DDTMotor/Debug_Card/doc/schematic.pdf

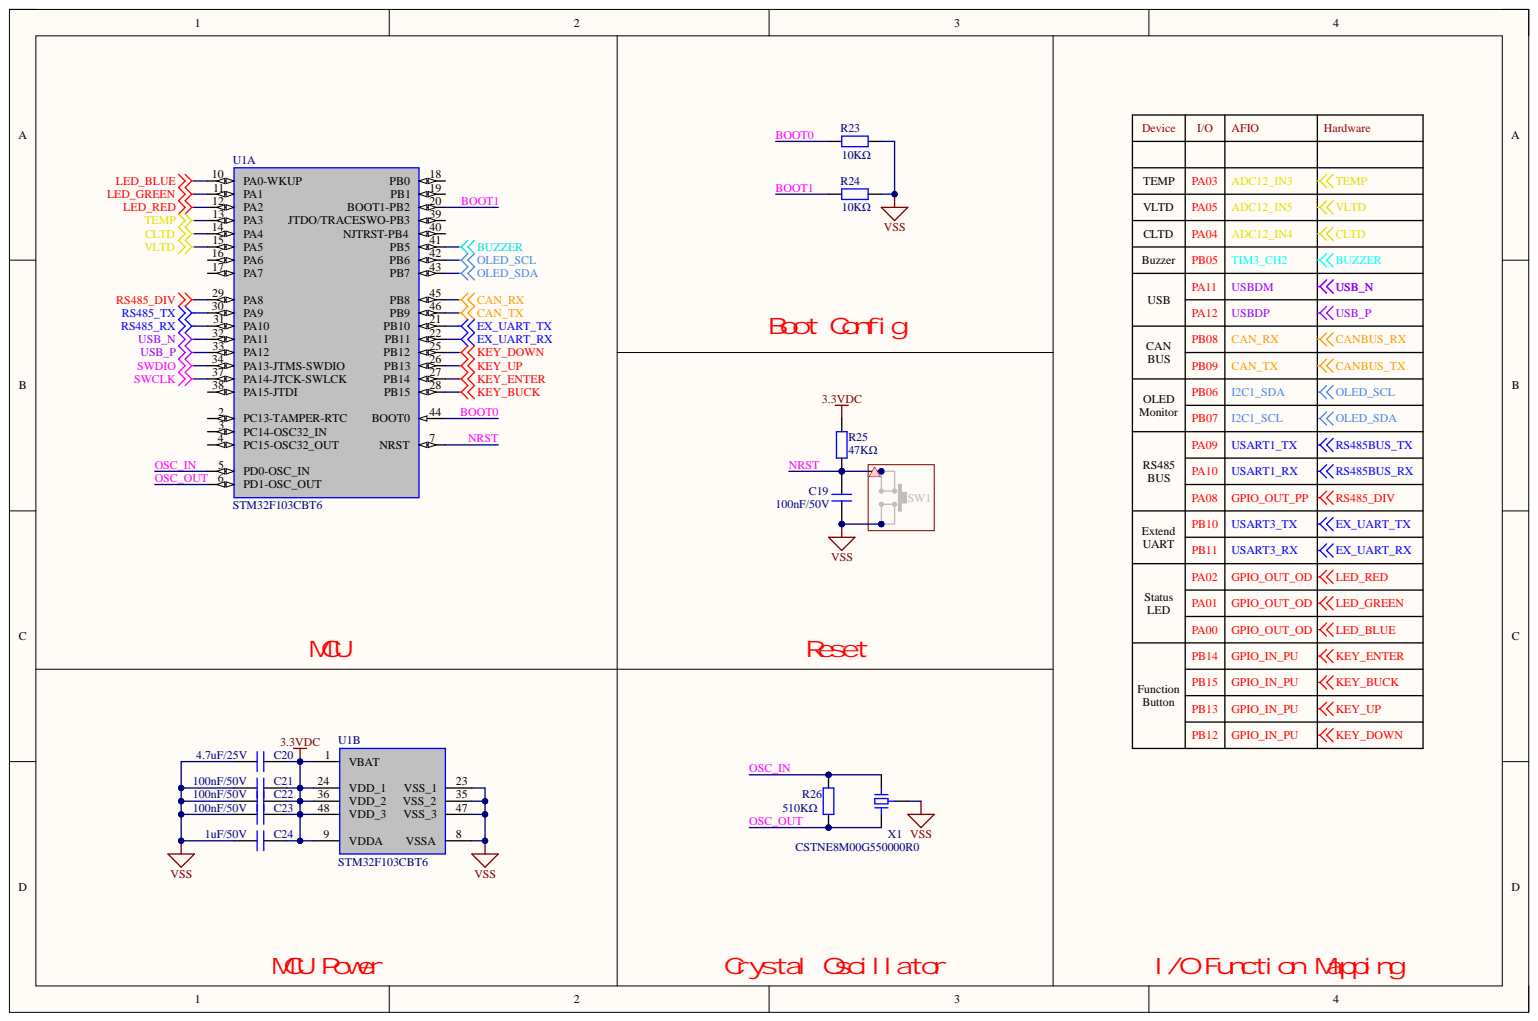
[picture p22: page 1]

CLTD | PA04 | ADC12_IN4 | CLTD

Buzzer | PB05 | TIM3_CH2 | BUZZER

USB | PA12 | USBDM USBDP PA11 | USB_N

USB_P

CAN BUS | PB08 | CAN_RX | CANBUS_RX

OLED | PB06 | I2C1_SDA | OLED_SCL

PB07 | I2C1_SCL | OLED_SDA

RS485 BUS | PA09 | USART1_TX PA10 | RS485BUS_TX

USART1_RX | RS485BUS_RX

PA08 | GPIO_OUT_PP | RS485_DIV

Extend UAR T | PB10 | USART3_TX | EX_UART_TX

PB1 1 | USART3_RX | EX_UART_RX

PA02 | GPIO_OUT_OD | LED_RED PA01 PA00 LED_GREEN

Status LED
Function Button | PB14 | GPIO_IN_PU GPIO_OUT_OD GPIO_OUT_OD GPIO_IN_PU GPIO_IN_PU GPIO_IN_PU | KEY_ENTER

LED_BLUE

PB15 | | KEY_BUCK

PB13 | | KEY_UP

PB12 | | KEY_DOWN

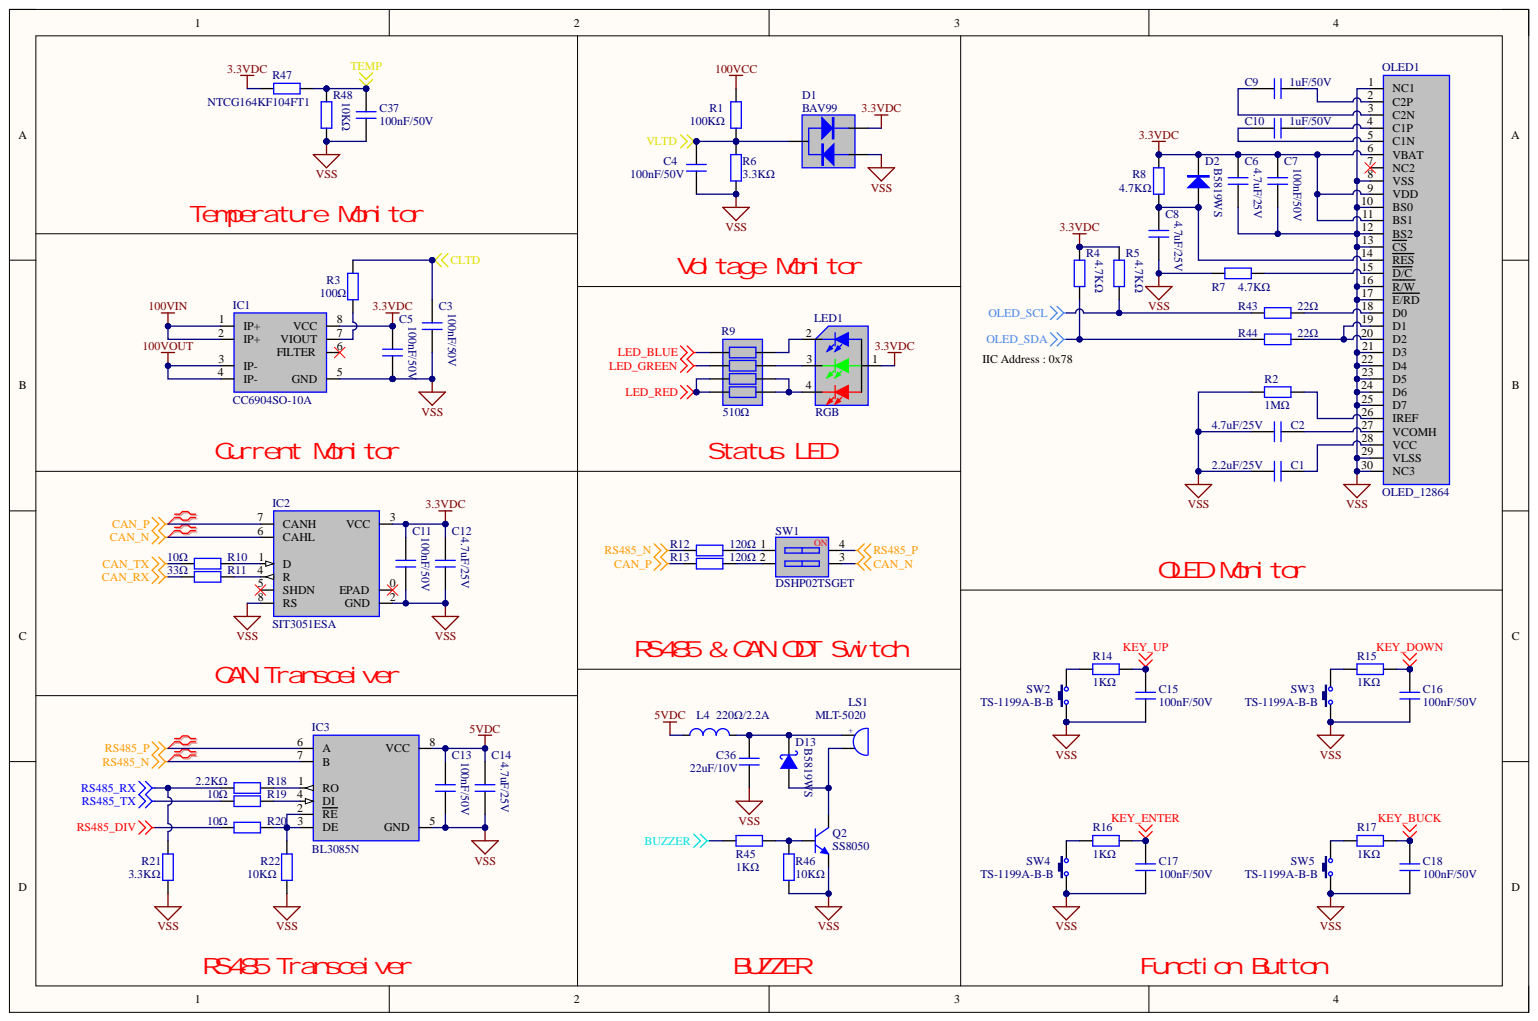
[picture p23: page 2]

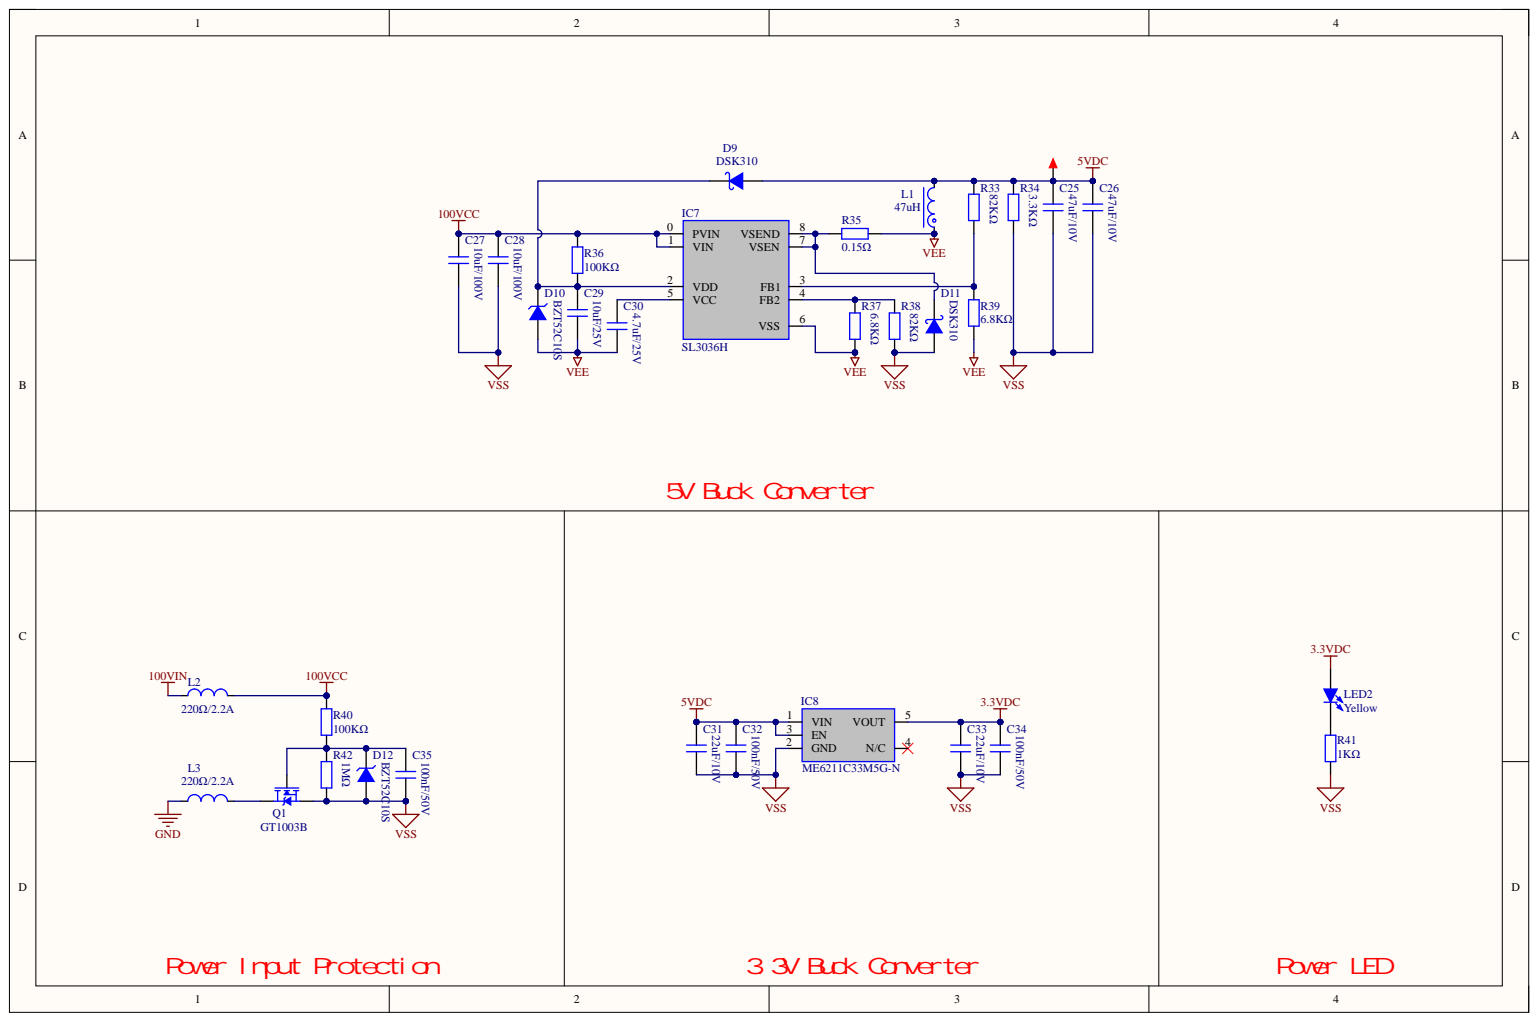
[picture p24: page 3]

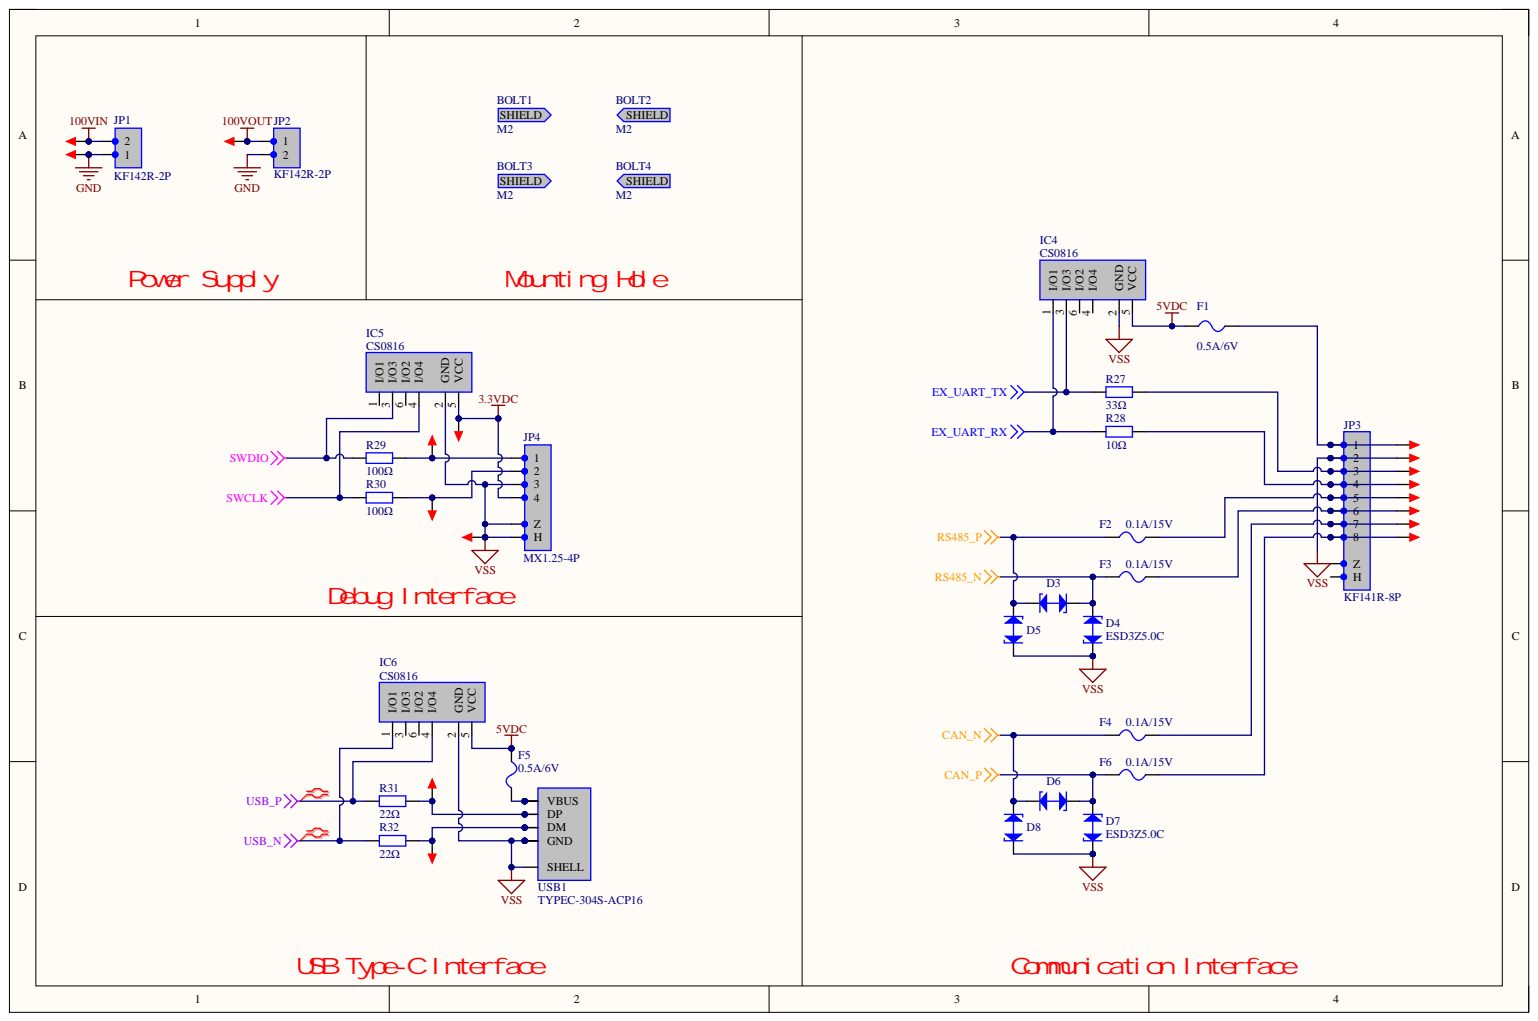
[picture p25: page 4]

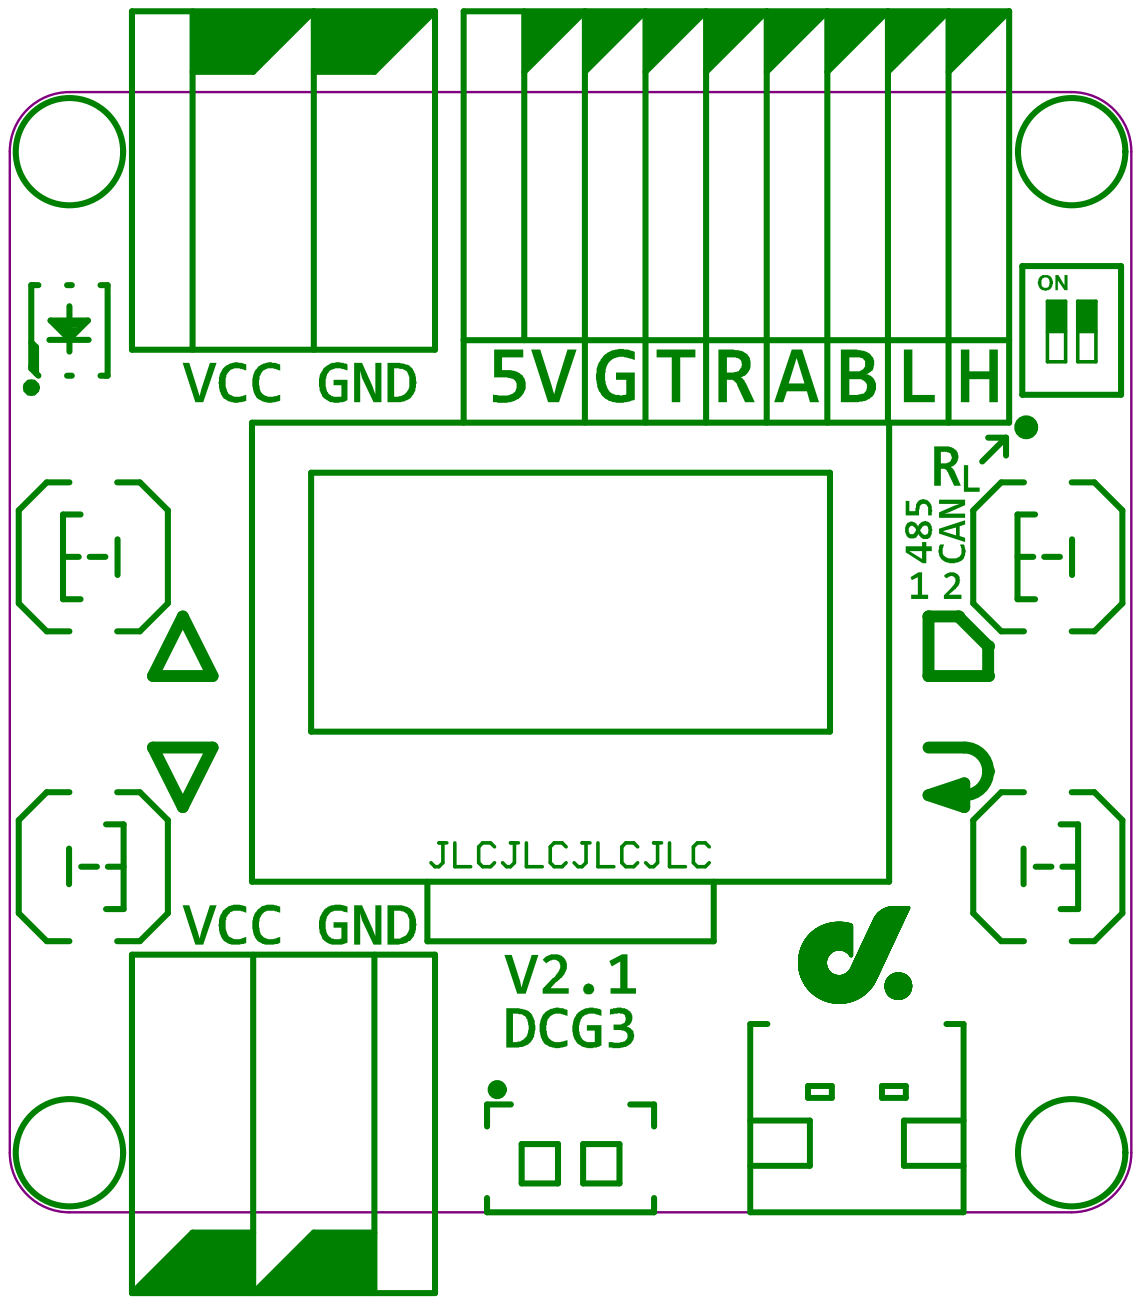
[picture p26: page 5]

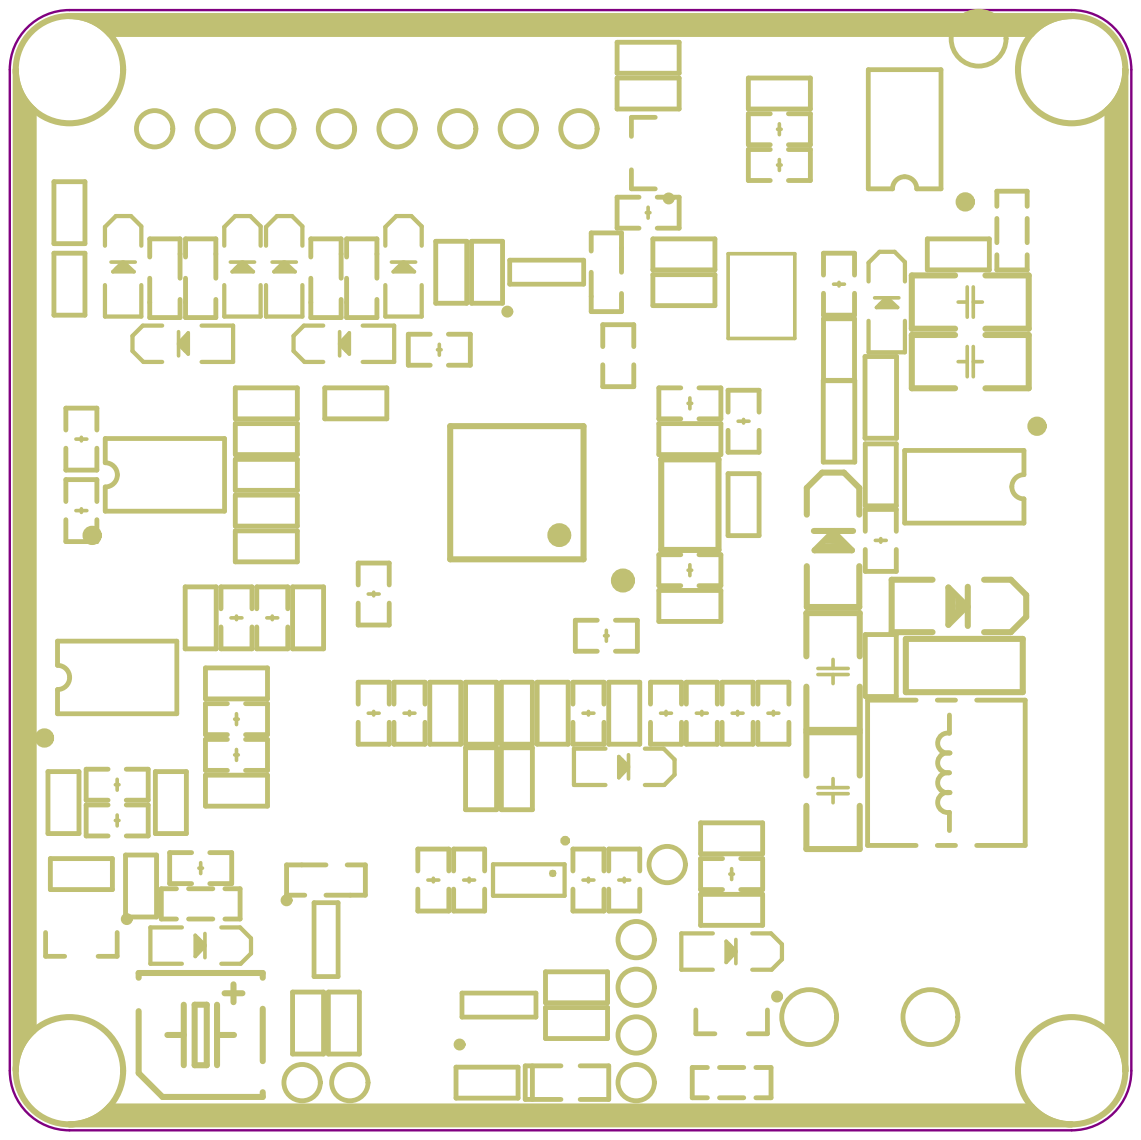
[picture p27: page 6]
