DDTMotor/Debug_Card/Core/Inc/main.h

#define LED_BLUE_Pin GPIO_PIN_0
#define LED_BLUE_GPIO_Port GPIOA
#define LED_GREEN_Pin GPIO_PIN_1
#define LED_GREEN_GPIO_Port GPIOA
#define LED_RED_Pin GPIO_PIN_2
#define LED_RED_GPIO_Port GPIOA
#define KEY_DOWN_Pin GPIO_PIN_12
#define KEY_DOWN_GPIO_Port GPIOB
#define KEY_UP_Pin GPIO_PIN_13
#define KEY_UP_GPIO_Port GPIOB
#define KEY_ENTER_Pin GPIO_PIN_14
#define KEY_ENTER_GPIO_Port GPIOB
#define KEY_BACK_Pin GPIO_PIN_15
#define KEY_BACK_GPIO_Port GPIOB
#define RS485_DIR_Pin GPIO_PIN_8
#define RS485_DIR_GPIO_Port GPIOA
#define BUZZER_Pin GPIO_PIN_5
#define BUZZER_GPIO_Port GPIOB
#define OLED_SCL_Pin GPIO_PIN_6
#define OLED_SCL_GPIO_Port GPIOB
#define OLED_SDA_Pin GPIO_PIN_7
#define OLED_SDA_GPIO_Port GPIOB
#define CAN_RX_Pin GPIO_PIN_8
#define CAN_RX_GPIO_Port GPIOB
#define CAN_TX_Pin GPIO_PIN_9
#define CAN_TX_GPIO_Port GPIOB
