DDTMotor/Debug_Card/Application/Task/task_motor_can.h

#ifndef __TASK_MOTOR_CAN_H__
#define __TASK_MOTOR_CAN_H__

/* ---------------------------- user header file ---------------------------- */
#include "task_schedule.h"

/* -------------------------- function declaration -------------------------- */

void mytask_can_entry(void *p_self);

#endif
