DDTMotor/Debug_Card/Application/Task/task_buzzer.h

#ifndef __TASK_BUZZER_H__
#define __TASK_BUZZER_H__

/* ---------------------------- user header file ---------------------------- */
#include "task_schedule.h"
#include "device_buzzer.h"


/* --------------------------- struct and enum definitions --------------------------- */

void mytask_buzzer_entry(void *p_self);

#endif
