DDTMotor/Debug_Card/Application/Task/task_key.h

#ifndef __TASK_KEY_H__
#define __TASK_KEY_H__

/* ---------------------------- user header file ---------------------------- */
#include "task_schedule.h"



/* -------------------------- function declaration -------------------------- */

void mytask_key_entry(void *p_self);

#endif
