DDTMotor/Debug_Card/Application/Task/task_led.h

#ifndef __TASK_LED_H__
#define __TASK_LED_H__

/* ---------------------------- user header file ---------------------------- */
#include "device_led.h"

/* -------------------------- function declaration -------------------------- */

void mytask_led_entry(void *p_self);

#endif
