DDTMotor/Debug_Card/Application/Task/task_menu.h

#ifndef __TASK_MENU_H__
#define __TASK_MENU_H__

/* ---------------------------- user header file ---------------------------- */
#include "task_schedule.h"

/* -------------------------- function declaration -------------------------- */

void menu_page_switch_callback(void *private_data);

void mytask_menu_entry(void *p_self);

#endif
