DDTMotor/Debug_Card/(commit log)

2024-08-05 fix(Location)：add version info in oled ui
    [device.h, device_buzzer.h, device_key.h, device_led.h, device_menu.c]
2024-08-05 fix(location)：Turn off log printing
2024-08-05 fix(location)：Modify function comments
2024-08-05 fix(location)：Change the readme 1. Change the file directory schema
    [device.h, device_buzzer.h, device_key.h, device_led.h, device_menu.c]
