DDTMotor/Debug_Card/(notices)

Notices in the files:
SEGGER_RTT/SEGGER_RTT_printf.c:
(c) 1995 - 2021 SEGGER Microcontroller GmbH
All rights reserved.
OLED/OLED.c:
@Copyright: Copyright (C) 2021-2024 ¶«Ý¸ÊÐ±¾Ä©¿Æ¼¼ÓÐÏÞ¹«Ë¾
Core/Inc/main.h:
Copyright (c) 2024 STMicroelectronics.
This software is licensed under terms that can be found in the LICENSE file
